svrooij/Xiaomi-Scooter-Motion-Control/Graph_Throttle_20kmh.png

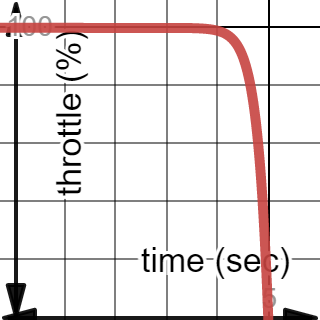
Graph_Throttle_20kmh.png
