svrooij/Xiaomi-Scooter-Motion-Control/(commit log)

2021-06-24 Update and rename Arduino_Script_v1.0.ino to Arduino_Script_v1.1.ino
2021-06-27 Update and rename Arduino_Script_v1.1.ino to Arduino_Script_v1.2.ino
2021-07-13 Prevent boost count reset by braking
    From now on, the duration of the boost is only reset when driving < THROTTLE_MIN_KMH.
    [Arduino_Script_v3.0.ino]
